mickkn/IRCoinSlot/img/header.drawio.png

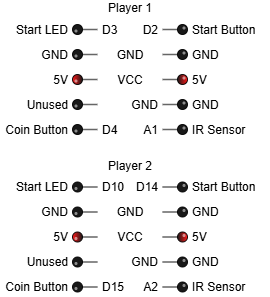
img/header.drawio.png
