mickkn/IRCoinSlot/img/wiring.png

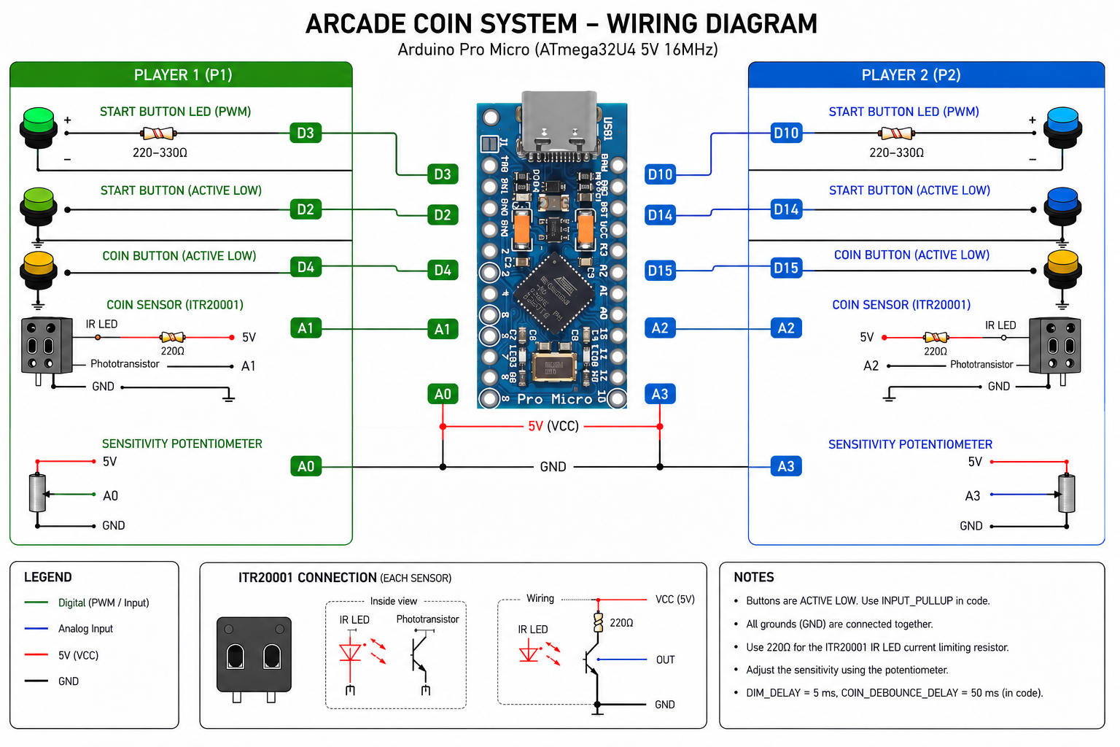
img/wiring.png
